SreeniEadara/ElectriPi-mini/PowerPi-zero.kicad_pcb

## KiCad design PowerPi-zero.kicad_pcb (2022-12-20)

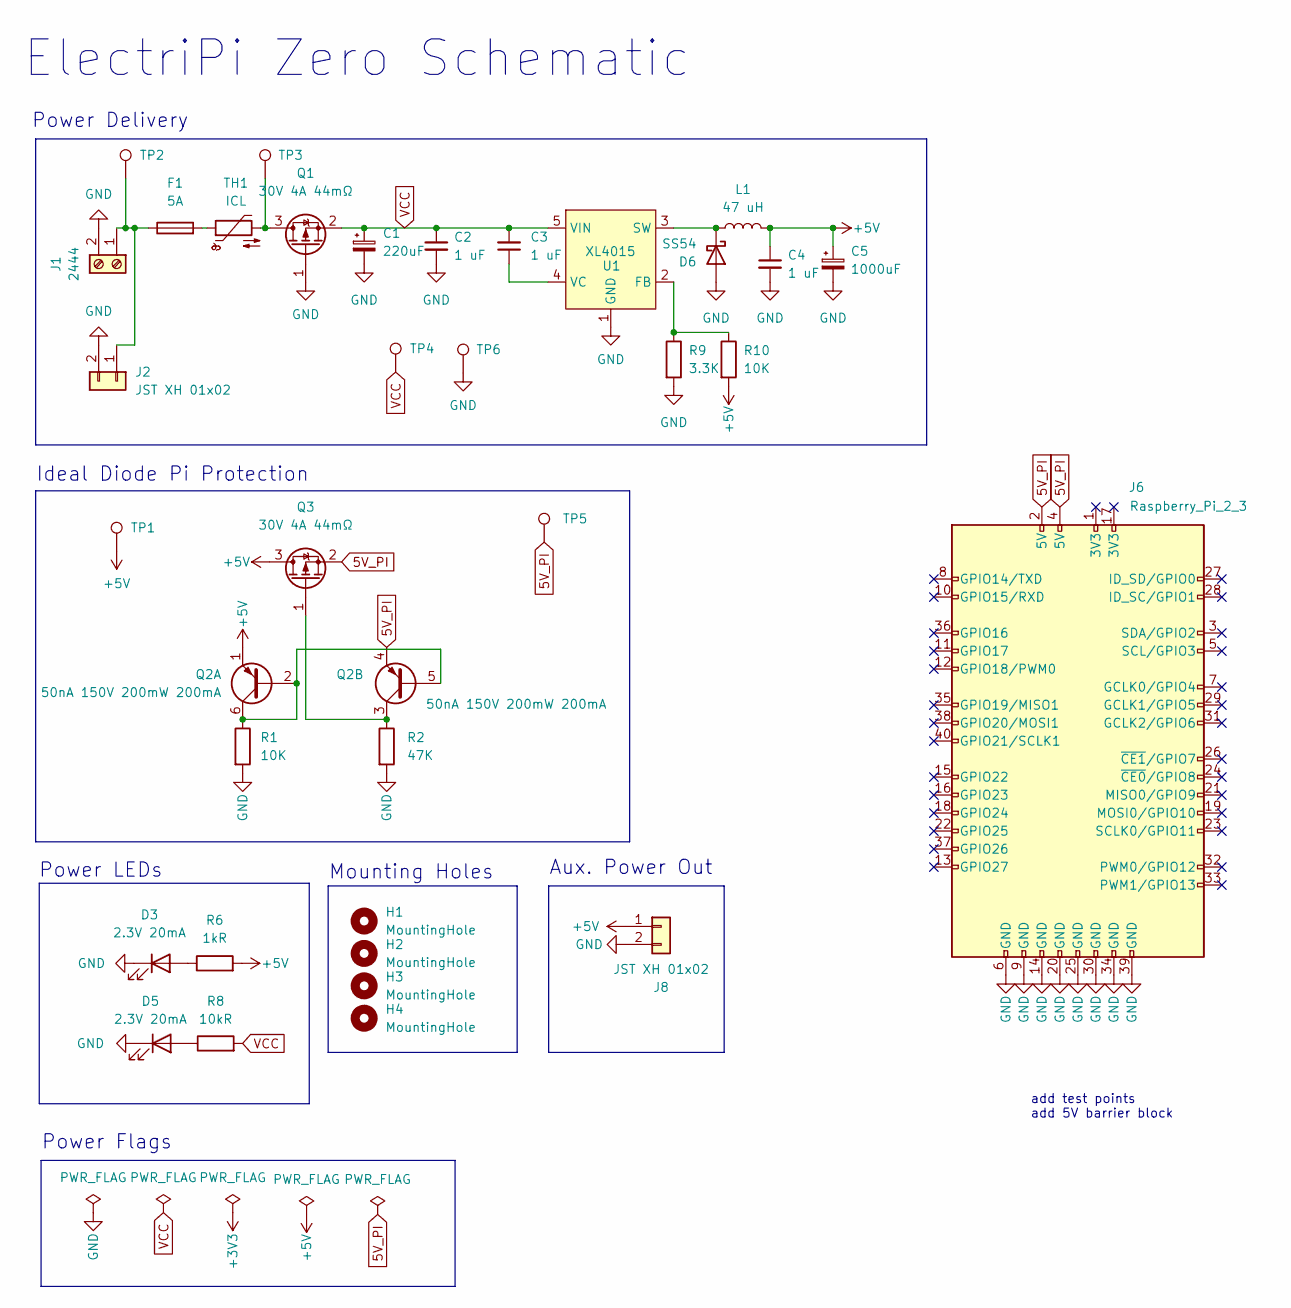
[picture p1: schematic PowerPi-zero.kicad_sch]

Parts:
C1: 220uF; CP_Elec_10x10; LCSC C176670
C2, C3, C4: 1 uF; C_0603_1608Metric; LCSC C15849
C5: 1000uF; CP_Elec_8x10; LCSC C310838
D3, D5: 2.3V 20mA; LED_0603_1608Metric; LCSC C72038
D6: SS54; D_SMA; LCSC C22452
F1: 5A; Fuse_Littelfuse-NANO2-451_453; LCSC C108518
H1, H2, H3, H4: MountingHole; MountingHole_2.7mm_M2.5_DIN965_Pad
J1: 2444; TerminalBlock_4Ucon_1x02_P3.50mm_Horizontal
J2, J8: JST XH 01x02; JST_XH_B2B-XH-A_1x02_P2.50mm_Vertical; LCSC C492456
J6: Raspberry_Pi_2_3; PinSocket_2x20_P2.54mm_Vertical
L1: 47 uH; L_12x12mm_H6mm; LCSC C497913
Q1, Q3: 30V 4A 44mΩ; SOT-23; LCSC C15127
Q2: 50nA 150V 200mW 200mA; SOT-363_SC-70-6; LCSC C54540
R1: 10K; R_0402_1005Metric; LCSC C25804
R2: 47K; R_0402_1005Metric; LCSC C25792
R6: 1kR; R_0402_1005Metric; LCSC C25087
R8: 10kR; R_0402_1005Metric; LCSC C25867
R9: 3.3K; R_0603_1608Metric; LCSC C22978
R10: 10K; R_0603_1608Metric; LCSC C25804
TH1: ICL; 5_OR_7pt5_PITCH_ICL
TP1, TP2, TP3, TP4, TP5, TP6: TestPoint; TestPoint_Pad_D1.5mm
U1: XL4015; TO-263-5_TabPin3; LCSC C51661

Connections:
5V_PI: J6.2 (5V), J6.4 (5V), Q2.4 (E2), Q3.2 (S), TP5.1
+5V: C4.1, C5.1, J8.1, L1.2, Q2.1 (E1), Q3.3 (D), R6.2, R10.2, TP1.1
GND: C1.2, C2.2, C4.2, C5.2, D3.1 (K), D5.1 (K), D6.2 (A), J1.2, J2.2, J6.6 (GND), J6.9 (GND), J6.14 (GND), J6.20 (GND), J6.25 (GND), J6.30 (GND), J6.34 (GND), J6.39 (GND), J8.2, Q1.1 (G), R1.2, R2.2, R9.2, TP6.1, U1.1 (GND)
unnamed: C3.1, U1.4 (VC)
unnamed: D3.2 (A), R6.1
unnamed: D5.2 (A), R8.1
unnamed: D6.1 (K), L1.1, U1.3 (SW)
unnamed: F1.1, J1.1, J2.1, TP2.1
unnamed: F1.2, TH1.1
unnamed: Q1.3 (D), TH1.2, TP3.1
unnamed: Q2.2 (B1), Q2.5 (B2), Q2.6 (C1), R1.1
unnamed: Q2.3 (C2), Q3.1 (G), R2.1
unnamed: R9.1, R10.1, U1.2 (FB)
VCC: C1.1, C2.1, C3.2, Q1.2 (S), R8.2, TP4.1, U1.5 (VIN)

Notes on the sheet:
ElectriPi Zero Schematic
Power LEDs
Ideal Diode Pi Protection
add test points add 5V barrier block
Power Delivery
Mounting Holes
Aux. Power Out
Power Flags

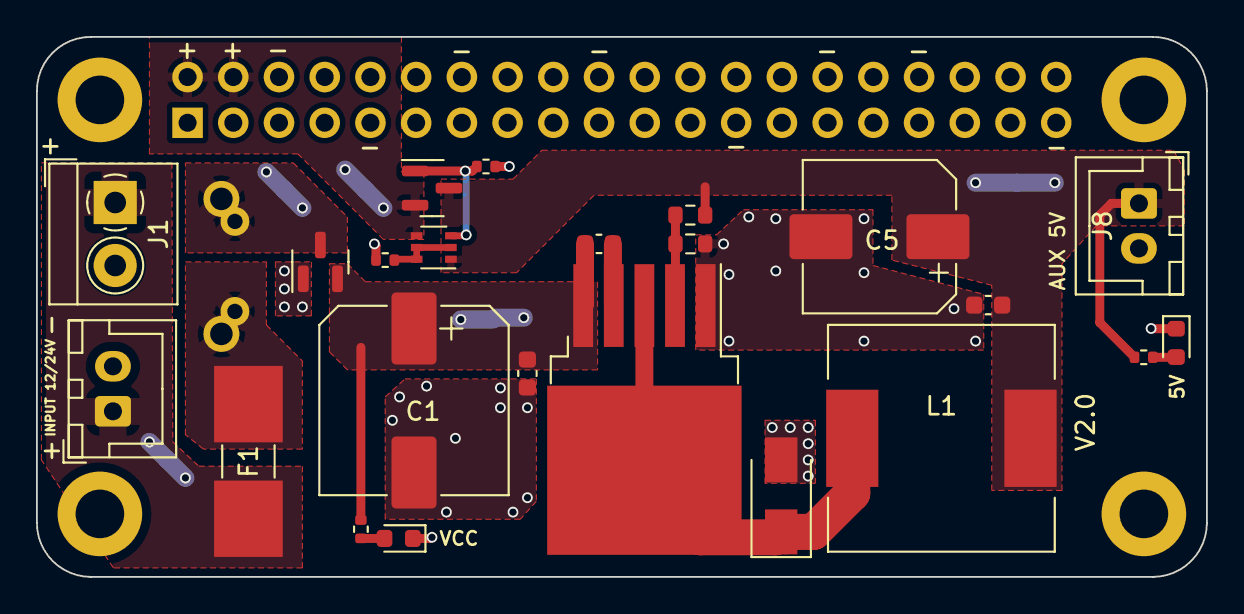
[picture p2: board PowerPi-zero.kicad_pcb from above]

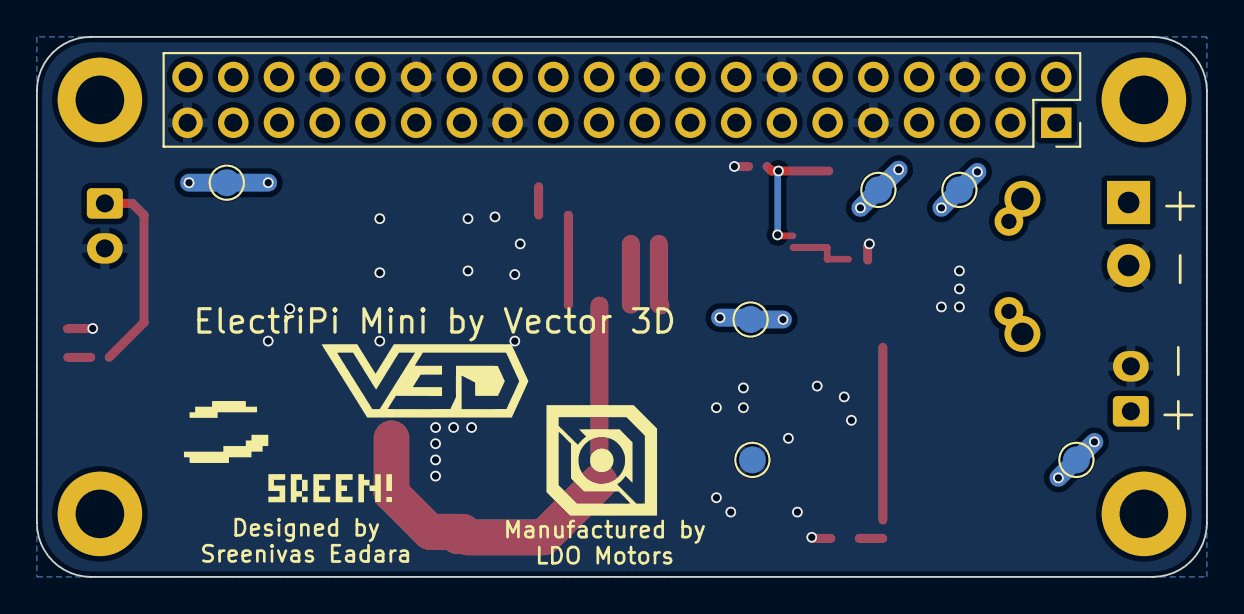
[picture p3: board PowerPi-zero.kicad_pcb from below]

Board: 2 copper layers, 65.0 x 30.0 mm, 35 parts (7 on the bottom side), 14 nets.
