SreeniEadara/ElectriPi-mini/(commit log)

2022-05-22 renaming to PowerPi-zero
    [PowerPi-zero-JLC.csv, PowerPi-zero-PCBway.csv, PowerPi-zero.csv, PowerPi-zero.kicad_pcb, PowerPi-zero.kicad_sch]
2022-05-22 Layout complete for PowerPi zero
    [PowerPi-zero.kicad_pcb, PowerPi-zero.kicad_sch]
2022-05-25 updated layout
    [PowerPi-zero.kicad_pcb]
2022-05-26 updated layout and improved copper balance
    [PowerPi-zero.kicad_pcb]
2022-07-07 update to 1000 uF output electrolytic capacitor
    [PowerPi-zero.kicad_pcb, PowerPi-zero.kicad_sch]
2022-12-19 Brought full design up to date with ElectriPi
    Main development was done on ElectriPi so now ElectriPi mini matches those developments
    [PowerPi-zero.kicad_pcb, PowerPi-zero.kicad_sch]
2022-12-20 Updated layout, esp. component position around input side
    [PowerPi-zero.kicad_pcb]
2022-12-20 Changed thermal reliefs for ICL
    [PowerPi-zero.kicad_pcb]
2022-12-20 Final tweaks for producion
    [PiPowerHAT-B_Cu.gbr, PiPowerHAT-B_Mask.gbr, PiPowerHAT-B_Paste.gbr, PiPowerHAT-B_Silkscreen.gbr, PiPowerHAT-Edge_Cuts.gbr, PiPowerHAT-F_Cu.gbr, PiPowerHAT-F_Mask.gbr, PiPowerHAT-F_Paste.gbr]
